w0rxbend/plastic-lighthouse/stl/fit_test.stl

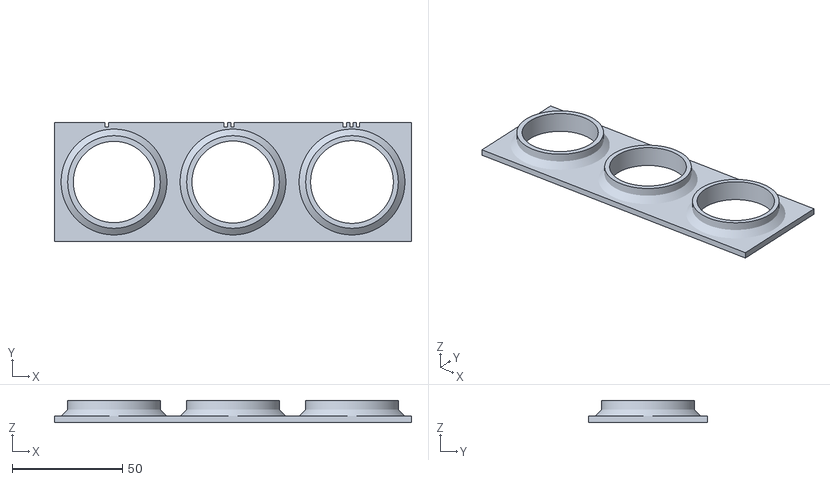
[picture p4: CAD file, 2026-09-27]
stl/fit_test.stl
162.0 x 54.0 x 10.0
