w0rxbend/plastic-lighthouse/stl/round/baffle.stl

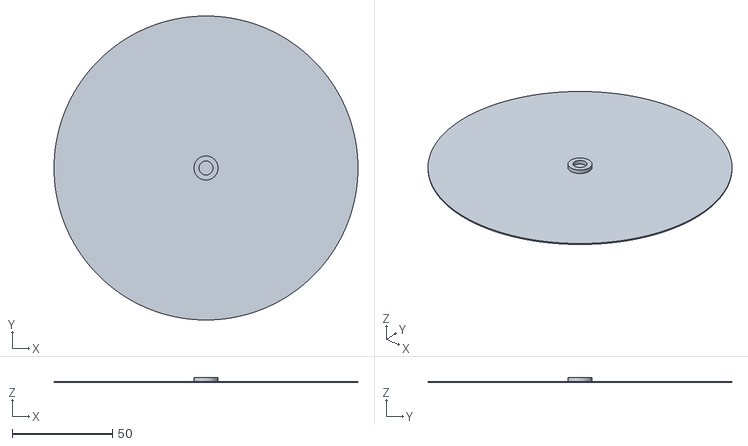
[picture p5: CAD file, 2026-09-27]
stl/round/baffle.stl
151.7 x 151.7 x 2.60
