w0rxbend/plastic-lighthouse/stl/square/frame.stl

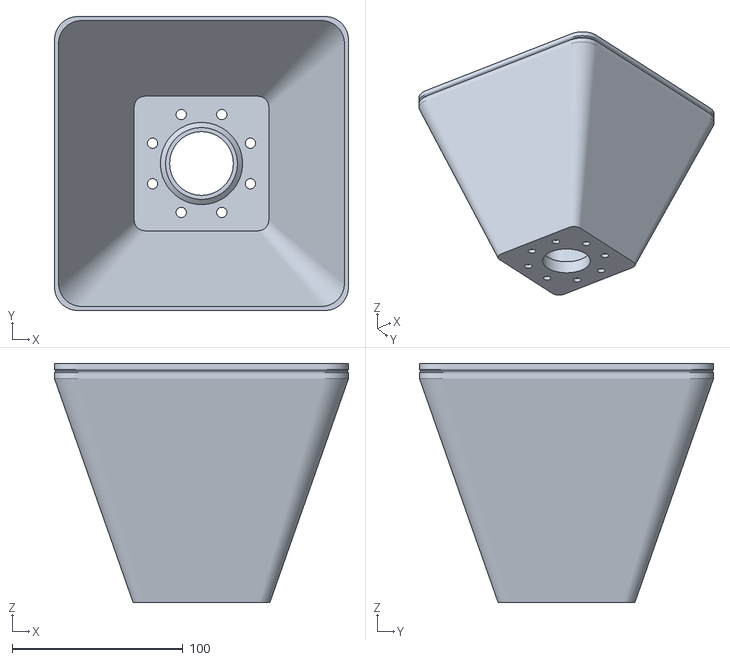
[picture p6: CAD file, 2026-09-27]
stl/square/frame.stl
172.0 x 172.0 x 140.0
