w0rxbend/plastic-lighthouse/stl/round/frame.stl

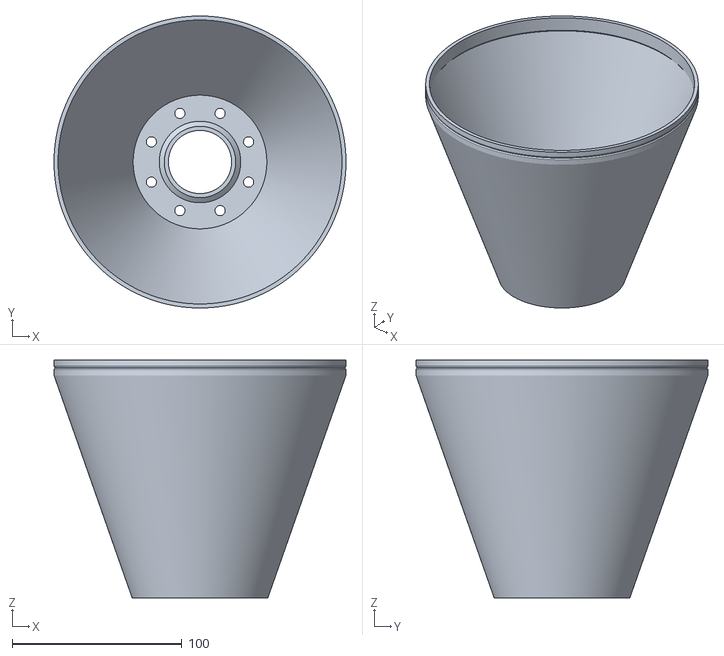
[picture p7: CAD file, 2026-09-27]
stl/round/frame.stl
172.0 x 172.0 x 140.0
