w0rxbend/plastic-lighthouse/stl/square/baffle.stl

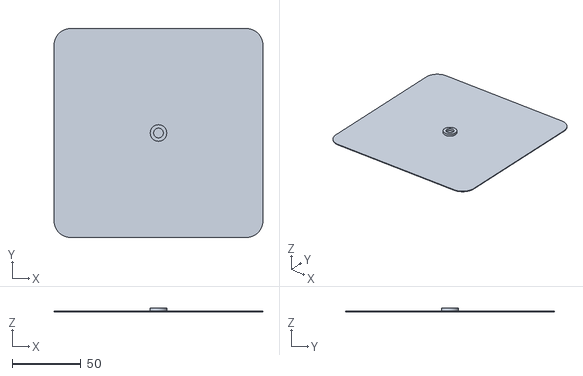
[picture p8: CAD file, 2026-09-27]
stl/square/baffle.stl
151.7 x 151.7 x 2.60
