w0rxbend/plastic-lighthouse/stl/round/diffuser.stl

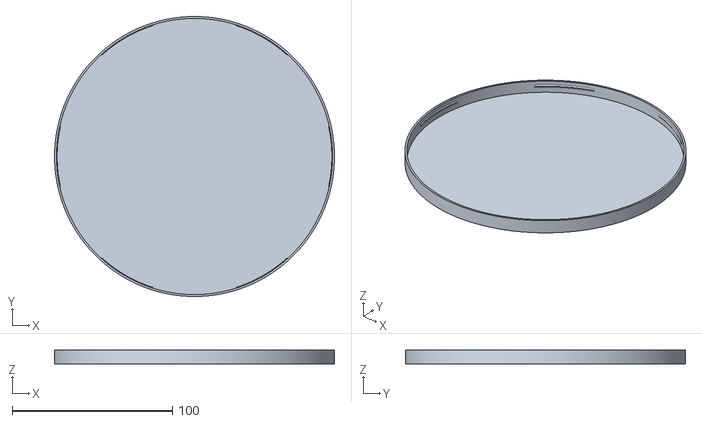
[picture p9: CAD file, 2026-09-27]
stl/round/diffuser.stl
174.8 x 174.8 x 8.80
