w0rxbend/plastic-lighthouse/stl/square/diffuser.stl

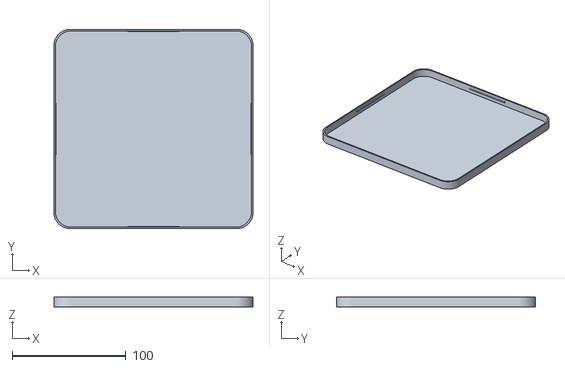
[picture p10: CAD file, 2026-09-27]
stl/square/diffuser.stl
174.8 x 174.8 x 8.80
